iNkawuVervetProject/VerTIGo/devices/BMS-adapter/BMS-adapter.step

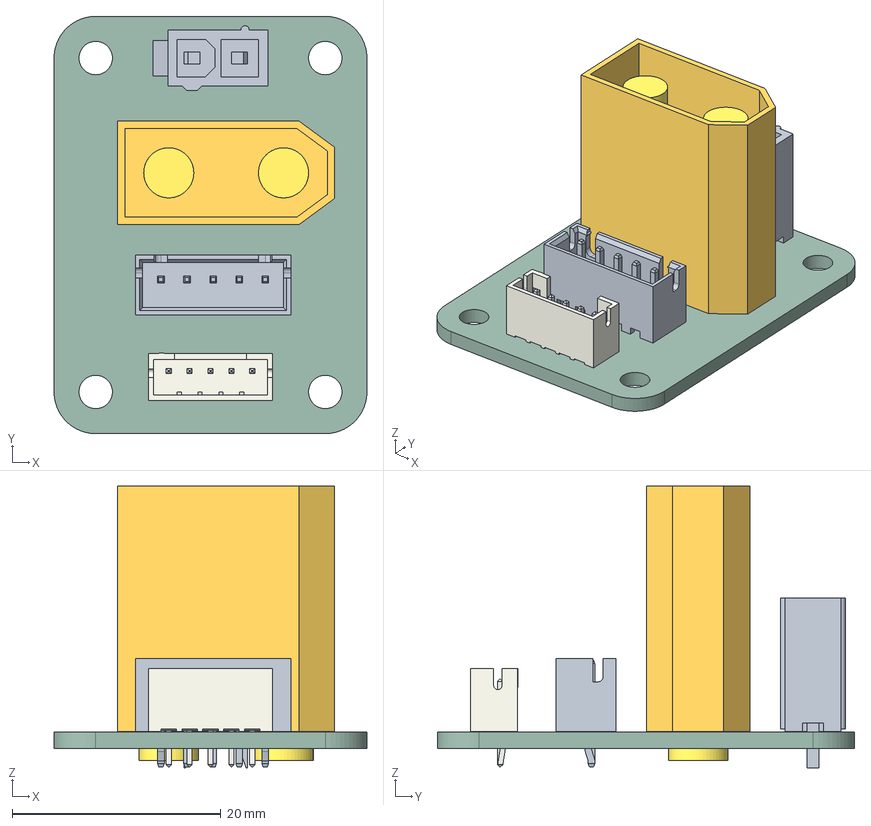
[picture p1: CAD file, 2024-06-10]
devices/BMS-adapter/BMS-adapter.step
30.0 x 40.0 x 27.0 mm
B5B-XH-A
JST_B5B_PH_K
_autosave-BMS-adapter_PCB
