iNkawuVervetProject/VerTIGo/devices/pi-HAT-IO/ecad/pi-HAT-IO.step

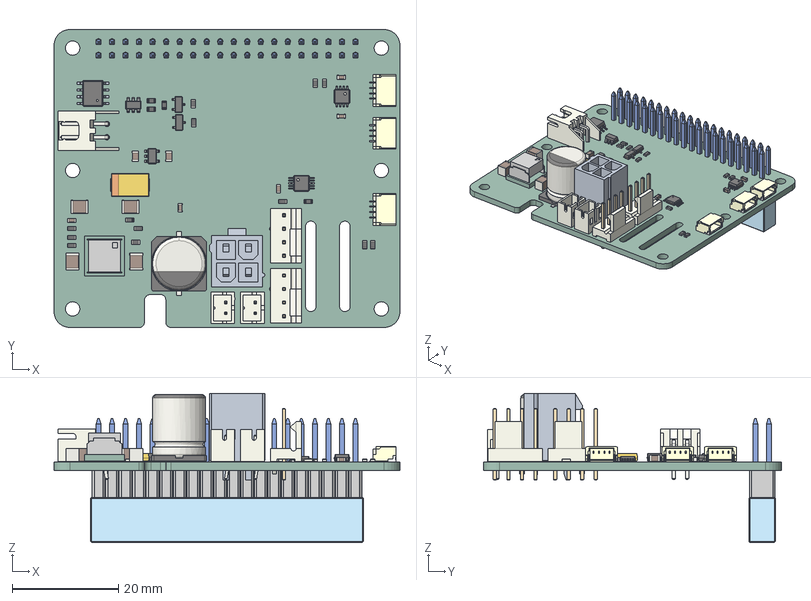
[picture p2: CAD file, 2024-03-05]
devices/pi-HAT-IO/ecad/pi-HAT-IO.step
65.0 x 56.0 x 28.0 mm
R_0603_1608Metric x 17
C_0603_1608Metric x 5
SSOP_8_295x28mm_P065mm
SOT_23_6
CP_EIA_7343_15_Kemet_W
C_0805_2012Metric x 2
SM04B-SRSS-TB(LF)(SN) x 3
JST_S2B_XH_A
SOT_23 x 2
JST_B2B_PH_K x 2
Inductor
PCB
C_1210_3225Metric x 4
Fan_Pin_Header_Straight_1x04 x 2
MSOP_10_3x3mm_P05mm
CQ assembly
CP_Elec_10x126
SOT_23_5
pi-HAT-IO_PCB
