iNkawuVervetProject/VerTIGo/devices/PowerJack-adapter/PowerJack-adapter.step

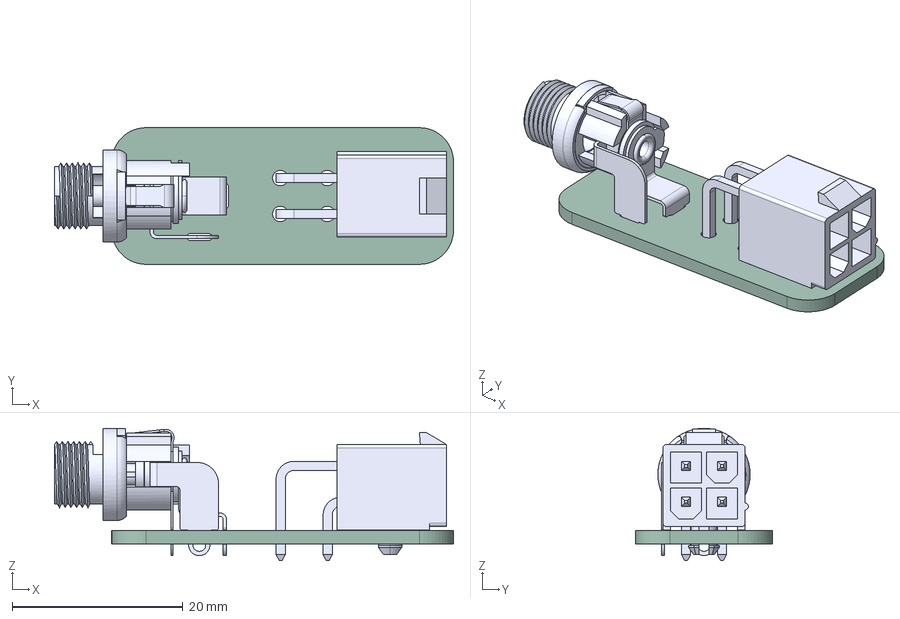
[picture p3: CAD file, 2024-06-10]
devices/PowerJack-adapter/PowerJack-adapter.step
46.7 x 16.0 x 15.5 mm
PowerJack-adapter_PCB
