iNkawuVervetProject/VerTIGo/documentation/source/sfguides/index.rst

.. VerTIGo Software Guides

###############
Software Guides
###############

.. toctree::
   :maxdepth: 1
   :caption: Guides:

   connecting_to_vertigo.rst
