iNkawuVervetProject/VerTIGo/documentation/source/hwguides/index.rst

.. VerTIGo Hardware Guides

###############
Hardware Guides
###############

.. toctree::
   :maxdepth: 1
   :caption: Guides:

   replace_battery
   replace_dispenser_wheel
