iNkawuVervetProject/VerTIGo/devices/pellet-dispenser/firmware/src/Config.hpp

#pragma once

#include "DispenserController.hpp"
#include "PelletCounter.hpp"
#include "WheelController.hpp"
#include "pico/types.h"

enum class OutputChannel {
	A             = 0,
	B             = 1,
	STEPPER_MOTOR = 2,
};

struct Config {
	WheelController::Config Wheel;
	PelletCounter::Config   Pellet;

	DispenserController::Config Dispenser;
} __attribute__((packed));
