iNkawuVervetProject/VerTIGo/(commit log)

2024-01-05 Adds logging to the camera webserver
2024-02-07 Imports minimal ECAD RP2040 design
    [pellet_dispenser.kicad_pcb, pellet_dispenser.kicad_sch]
2024-02-07 [WIP] Pallet Dispenser
    [RP2040.kicad_sch, pellet_dispenser.kicad_pcb, pellet_dispenser.kicad_sch]
2024-02-08 [WIP] Adds connector
    [RP2040.kicad_sch, pellet_dispenser.kicad_pcb, pellet_dispenser.kicad_sch]
2024-02-08 First version of the pellet dispenser control board
    [RP2040.kicad_sch, pellet_dispenser.kicad_pcb, pellet_dispenser.kicad_sch]
2024-02-15 [WIP] BMS
    [bms.kicad_pcb, bms.kicad_sch, charger.kicad_sch, gauge.kicad_sch]
2024-02-15 [WIP] Pellet Dispenser
    [RP2040.kicad_sch, pellet_dispenser.kicad_pcb, pellet_dispenser.kicad_sch]
2024-02-17 [WIP] Powerboard
    [powerboard.kicad_pcb, powerboard.kicad_sch]
2024-02-23 [WIP][powerboard] changes the inductor
    [powerboard.kicad_pcb, powerboard.kicad_sch]
2024-02-24 Powerboard revA done
    [powerboard.kicad_pcb, powerboard.kicad_sch]
2024-02-26 Pellet Dispenser rev A
    [pellet_dispenser.kicad_pcb, pellet_dispenser.kicad_sch]
2024-02-26 Adds an IR Board Sensor
    [ir-sensor.kicad_pcb, ir-sensor.kicad_sch]
2024-02-26 Adds a Pi HAT IO board
    [pi-HAT-IO.kicad_pcb, pi-HAT-IO.kicad_sch]
2024-02-27 [Pellet] Changes connector implementation
    More Streamlined Top (Control + Power) -> Down (Sensor + Actuator) organization.
    Added the debug header on bottom layer (Only for development purpose).
    [pellet_dispenser.kicad_pcb, pellet_dispenser.kicad_sch]
2024-02-27 Adds model for HAT header
    [pi-HAT-IO.kicad_pcb, pi-HAT-IO.kicad_sch]
2024-02-27 Updates power distribution board
    [powerboard.kicad_pcb, powerboard.kicad_sch]
2024-02-28 Conforms all board together
    [ir-sensor.kicad_pcb, pellet_dispenser.kicad_pcb, pellet_dispenser.kicad_sch, pi-HAT-IO.kicad_pcb, powerboard.kicad_pcb, powerboard.kicad_sch]
2024-02-29 [WIP] [Dispenser] Replace DRV8847 with DRV8848
    It is a better part for reaching better stall current
    [pellet_dispenser.kicad_pcb, pellet_dispenser.kicad_sch]
2024-02-29 [Pellet] Replaces DRV8847 with DRV8848
    [pellet_dispenser.kicad_pcb, pellet_dispenser.kicad_sch]
2024-02-29 [Pellet] Add warning for hot parts
    [pellet_dispenser.kicad_pcb]
2024-02-29 [Pellet] Adds Test Point for Motor Current Sensing
    [pellet_dispenser.kicad_pcb, pellet_dispenser.kicad_sch]
2024-02-29 [IR Sensor] Updates to Allow Mixed Purpose.
    * Indicate that only part could be populated to have:
    * An IR emitter
    * An IR Phototransistor
    * Both (reflective mode)
    * Turn the IR Module so if flipped vertically barrier and IR are aligned.
    [ir-sensor.kicad_pcb]
2024-02-29 [Battery Holder] Adds a Battery Holder
    [battery-holder.kicad_pcb, battery-holder.kicad_sch]
2024-03-02 [WIP] Reworks HAT to handle power distribution
    [pi-HAT-IO.kicad_pcb, pi-HAT-IO.kicad_sch]
2024-03-04 Reworks HAT to handle power delivery and fan control
    [pellet_dispenser.kicad_pcb, pellet_dispenser.kicad_sch, pi-HAT-IO.kicad_pcb, pi-HAT-IO.kicad_sch, pi-HAT-IO.step]
2024-03-05 [HAT] Edit on some parts
    [pi-HAT-IO.step]
2024-03-05 Standardizes BoM
    [pellet_dispenser.kicad_sch, pi-HAT-IO.kicad_sch]
2024-03-05 Adds Exported BoM
    [BoM.csv, pi-HAT-IO.kicad_sch]
2024-03-06 Panelizes the IR Sensors
    [BoM.csv, ir-sensor.kicad_sch, panel.kicad_pcb]
2024-03-07 Adds license and output for IR Sensor
    [ir-sensor.kicad_pcb, ir-sensor.kicad_sch, panel.kicad_pcb]
2024-03-07 Removes Legacy Boards
    [battery-holder.kicad_pcb, battery-holder.kicad_sch, bms.kicad_pcb, bms.kicad_sch, charger.kicad_sch, gauge.kicad_sch, powerboard.kicad_pcb, powerboard.kicad_sch]
2024-03-07 Finishes Pellet Dispenser
    [BoM.csv, pellet_dispenser.kicad_pcb, pellet_dispenser.kicad_sch]
2024-03-07 Adds all datasheet for the Pi HAT
    [pi-HAT-IO.kicad_sch]
2024-03-11 Corrects PCB for production'
    [panel.kicad_pcb, pellet_dispenser.kicad_pcb, pi-HAT-IO.kicad_pcb, pi-HAT-IO.kicad_sch]
2024-03-12 Small Correction for pi-HAT
    [pi-HAT-IO.kicad_pcb]
2024-03-12 Adds a Jig to test JST connector
    [JST-jigs.kicad_pcb, JST-jigs.kicad_sch]
2024-04-10 Adds BOM
    [pellet_dispenser.kicad_pcb, pellet_dispenser.kicad_sch]
2024-04-10 Removes heavy pico datasheet
2024-04-11 [WIP] Adds boilerplate for pico firmware
2024-04-11 Makes an UART stupid clock
2024-04-11 Plays with a press button and display.
2024-04-12 BitBangs the IR Sensor
    Quite awful, but it works
    Also puts the debug formatting on another thread.
2024-04-12 Adds a PIO program to do drive the IR sensor and keep track of time.
2024-04-16 Implements a WheelController to move the Wheel.
2024-04-16 Fixes WheelController over shoot.
    [WheelController.cpp, main.cpp]
2024-04-16 Refactors WheelController
2024-04-16 Makes the WheelController report blocking errors.
    Also reports new position.
    Also invert direction after a while.
    [WheelController.cpp, WheelController.hpp]
2024-04-16 Replaces defines with const static variable
    [WheelController.cpp, WheelController.hpp]
2024-04-17 Removes the notion of wanted position on wheel controller
    This is left for an higher level.
2024-04-17 Refactors Display
    Now displays error.
    Improves the state presentation.
    [Display.cpp, Display.hpp, Error.hpp, WheelController.cpp, WheelController.hpp, main.cpp]
2024-04-23 Adds away to display message on debug UART
2024-04-24 Makes WheelController dumber
    the logic of reversing the direction should be held by the PelletController. The
    WheelController only start/stop the wheel, manage reverse pulse, and return
    fault conditions.
    [WheelController.cpp, WheelController.hpp]
2024-04-24 Reduces default stall time threshold.
    We should not overload the motor.
    [WheelController.hpp]
2024-04-26 Adds C++ Queue implementation.
    Such Queue can or cannot be threadsafe.
2024-04-30 Implements CalibrateMode
2024-04-30 First Calibration Implementation
2024-04-30 Implements Calibration
    Its is a two pass process:
    First try to stop at max speed, and find when it stop with a 5 ms step.
    Then redo it with a 500us step. between last and smallest.
2024-04-30 Implements CalibrationResult structure
2024-05-01 Modify min criterion for calibration.
    If can stop within the slot, (i.e. final position is 0), return the first one.
    If not possible, return the next position increase after the min element if one
    found.
2024-05-01 Allow for speed selection for calibration.
2024-05-01 Debugs Calibration
2024-05-01 Fixes FlashStorage bug
    Several instantiation where performed but only one should have been
    instantiated.
    [DispenserController.cpp, FlashStorage.hpp, main.cpp]
2024-05-01 Fixes Unique Compile time ID
    It should not be a variable function but a C preprocessor macro.
    Therfore we use cmake to generate this value, once per build.
    [FlashStorage.hpp, main.cpp]
2024-05-02 [WIP] LEDMorse code displayer.
2024-05-02 Implements the LEDMorse display
2024-05-02 Refactors ErrorReporter
    Adds display of active errors on the LED via morse code.
    Adds a log of Error.
    [DispenserController.cpp, Error.hpp, ErrorReporter.cpp, ErrorReporter.hpp, LEDMorse.cpp, main.cpp]
2024-05-02 Adds a Dispense Watchdog to avoid lock up
    [DispenserController.cpp, Error.hpp]
2024-05-02 Fixes deadlock while self-checking
    * WheelController only disable once the wheel sensor.
    * SelfCheck fails after 2ms if locked up.
    * SelfCheck force reenable the sensor if they were stopped concurrently.
    [DispenserController.cpp, Error.hpp, WheelController.cpp, WheelController.hpp]
2024-05-03 Implements USB protocol and sketches a driver
    Closes #1
    Related to #5
2024-06-05 [WIP] Adds a BMS adapter board
    [BMS-adapter.kicad_pcb, BMS-adapter.kicad_sch]
2024-06-10 Adds a PowerJack
    [BMS-adapter.kicad_pcb, BMS-adapter.kicad_sch, BMS-adapter.step, PowerJack-adapter.kicad_pcb, PowerJack-adapter.kicad_sch, PowerJack-adapter.step]
2024-06-12 Corrects URL in Pellet Dispenser driver pyproject.toml
2024-06-18 Hooks psychopy.session.Session.currentExperiment
2024-06-20 Make our own loop implementation which is much simpler
    We simply forget about the blocking shenanigans from psychopy.session (Hint: it
    is highly broken). And we added our own async function to expose to FastAPI,
    using future to control asynchronous operation between the main thread (that
    will be waiting on operation from the server thread) and the serving thread.
    It seems to work. at least once.
2024-06-20 Adds AsyncTaskRunner
    An helper class to allow run asynchronously subtask in a dedicated loop (which
    can live in another Thread).
2024-06-25 Adds configuration for nut
2024-06-25 Makes a base configuration for nut and nvme boot.
    [eeprom.cfg]
2024-06-28 Makes start/stop button work.
2024-06-28 Adds a battery service.
    On dev, it simply uses fake data.
    On deployment, it looks for openups on localhost via upsc.
2024-06-28 Adds Battery API Endpoint and client stores.
2024-07-01 [WIP] battery indicator
2024-07-01 Adds a battery indicator and pop-up warnings.
2024-07-01 Adds wheel package for raspberry pi bookworm
2024-07-02 Install global pyenv and pre-compiled wheels to targets
2024-07-02 Adds a button to show the desktop
2024-07-02 Improves transition for the show desktop button.
2024-07-03 [WIP] Custom NUT client
2024-07-03 Implements NUT protocol to get variable in Node.
2024-07-26 Updates driver to 0.0.2a1
2024-08-19 Starts the replace battery guide.
2024-08-19 Removes the deployment in case of a pull request.
2024-08-19 Finish the battery replacement guide.
2024-08-19 Adds a Dispenser Wheel replacement guide
2024-08-19 Adds relevant edit button.
    To make it a wiki like
2024-08-19 Makes a camera stream
2024-08-19 refactors CameraStream
2024-08-19 Allows for CameraStream to work properly if rtsp streaming as a failure
2024-08-19 Renames rpi-camera-service -> vertigo-camera
2024-08-19 Adds a vertigo-camera.service
2024-08-21 Makes the documentation clearer on which side to remove the battery.
2024-08-22 Computes the right url from the current origin.
2024-08-26 Installs vertigo-camera-webservice from local source.
2024-08-27 refactors battery state
2024-08-27 Updates battery state via events.
2024-08-27 [broken] Makes templates to redirect to CAMERA backend.
2024-08-27 Makes proxy api to vertigo-camera service
2024-08-27 Implements stub_state for camera
2024-08-28 [wip] stream camera
2024-08-28 Adds confirmation
    * Ask to start the camera on experiment start if not already started.
    * Ask confirmation to stop camera if any experience is running.
2024-08-29 Updates configuration to make the camera work.
2024-08-29 Makes vertigo-camera.service a user service
    We want the produced file to be owned by the vertigo user, not root. It is much
    simpler this way.
2024-08-29 Changes confirmation button text
2024-09-03 Makes it clearer when the start experiment button is not enabled.
2024-09-19 Adds settings to manage the camera and background color.
2024-09-25 Sets application_state to use object for camera and window.
2024-09-25 Update api/camera to the new api
2024-09-26 Unit test api/battery endpoint.
2024-09-30 Fixes framerate measurement while no experiment is yet running.
2024-09-30 Sets default settings for camera to manual focus.
2025-06-23 [webui] Adds a button for manual dispense
