iNkawuVervetProject/VerTIGo/(notices)

Notices in the files:
devices/pi-HAT-IO/ecad/pi-HAT-IO.kicad_pcb:
Licensed under CERN-OHL-S v2
devices/ir-sensor/ecad/ir-sensor.kicad_pcb:
Licensed under CERN-OHL-S v2 or any later version
Copyright Universitée de Lausanne 2024
devices/pi-HAT-IO/ecad/pi-HAT-IO.kicad_sch:
LIcensed under CERN-OHL-S v2 or later
devices/ir-sensor/ecad/ir-sensor.kicad_sch:
Copyright Université de Lausanne 2024
